JamesCarron/DiscreteOpAmp/DiscreteOpAmp_Schematics.html

# DiscreteOpAmp schematics

Every .SchDoc in C:\GitHub\DiscreteOpAmp, rendered with altium-monkey. Ctrl+scroll or browser zoom to read fine detail.

Show the whole sheet (border and title block) instead of cropping to the drawing

## Op-amp board — DiscreteOpAmp.PrjPcb

### Top level main.SchDoc

Hierarchy root: one sheet symbol per discrete design, plus a TLV271 IC op amp for comparison. Designators not yet annotated.

### Basic discrete op amp BasicDiscreteOpAmp.SchDoc

Four-transistor design: long-tailed pair, PNP gain stage, emitter-follower output.

### Advanced discrete op amp AdvancedDiscreteOpAmp.SchDoc

Current-mirror load, current-sink biasing, class-AB push-pull output.

### LM741 reference LM741_Design.SchDoc

The LM741 internal schematic as an embedded image, not drawn circuitry. In the project but not in the hierarchy or on the PCB.

## Function generator — FuncGen/FuncGen.PrjPcb

### Connectors FuncGen/Connectors.SchDoc

Top level of the function-generator project.

### Oscillator FuncGen/Oscillator.SchDoc

LMC555 square wave (trimmer-set frequency), then LMC6484 stages producing the triangle and sine outputs.

## Not in any project

### Connectors (root copy) Connectors.SchDoc

Stray copy in the repo root; differs from the FuncGen version.

### Oscillator (root copy) Oscillator.SchDoc

Stray copy in the repo root; differs from the FuncGen version.
