JamesCarron/DiscreteOpAmp/Documentation/LM741_DiscreteDesign.png

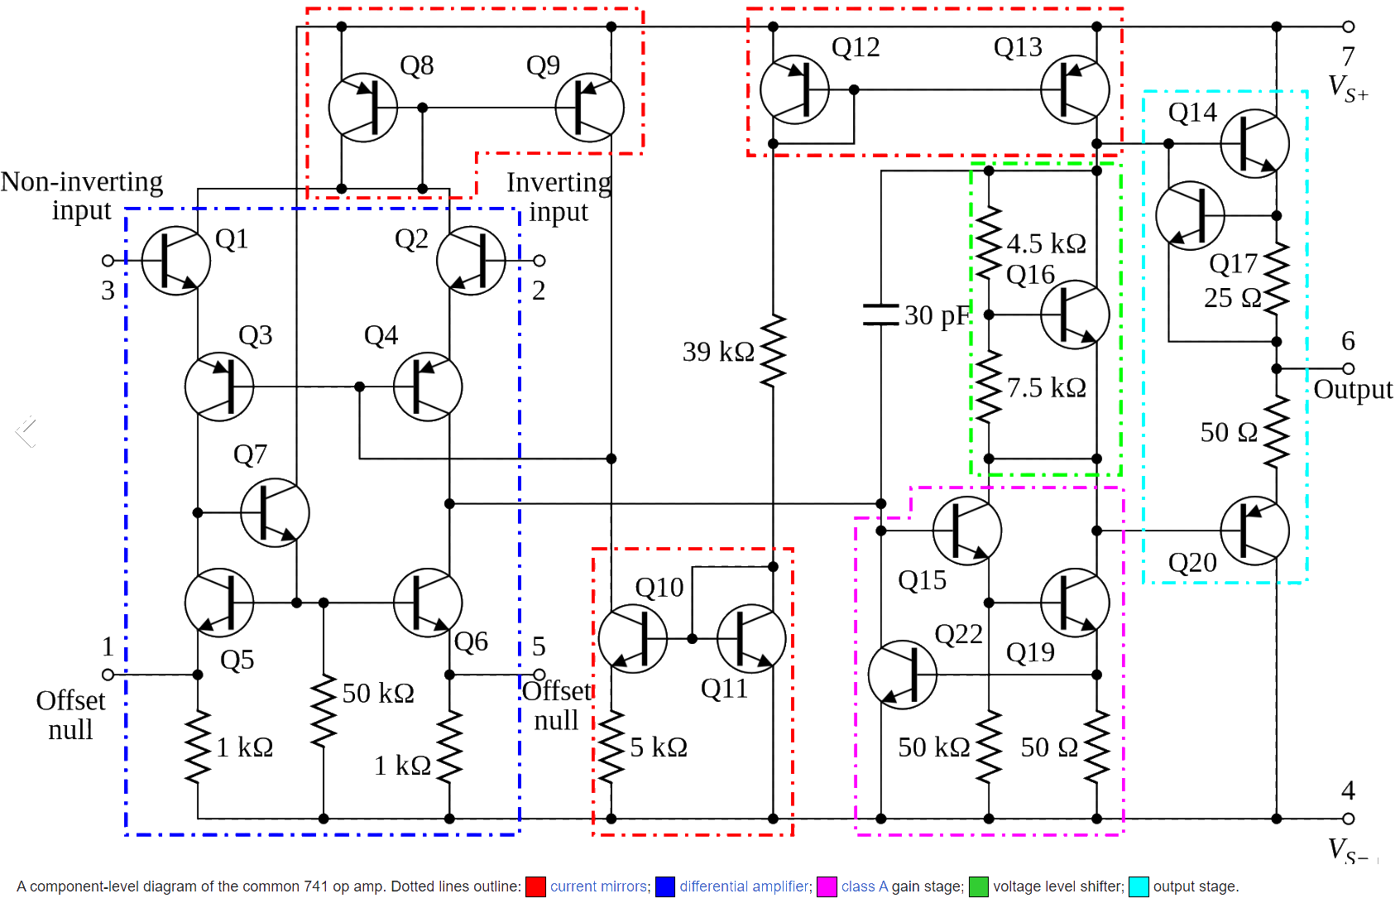
Documentation/LM741_DiscreteDesign.png
