JamesCarron/DiscreteOpAmp/(list of files, drawings)

Other design files:
AdvancedDiscreteOpAmp.SchDoc
BasicDiscreteOpAmp.SchDoc
Connectors.SchDoc
DiscreteOpAmp.PrjPcb
FuncGen/Connectors.SchDoc
FuncGen/FuncGen.PcbDoc
FuncGen/FuncGen.PrjPcb
FuncGen/Oscillator.SchDoc
LM741_Design.SchDoc
main.SchDoc
ModernOpAmp.SchDoc
Oscillator.SchDoc
PCB1.PcbDoc
PCB_Project/PCB_Project.PrjPcb
