JamesCarron/DiscreteOpAmp/(commit log)

2023-10-24 Generated Gerbers, added Docs
2026-10-19 Rewrite README: describe both projects, reference material and build status
2026-10-19 README: correct circuit descriptions against the schematics; note unannotated top sheet and stray wire
2026-10-19 Add rendered schematics page (all sheets as one self-contained HTML)
2026-10-19 README: walk through each circuit with schematic renders and reference images; add review notes on the FuncGen op-amp stages
2026-10-19 README: show the LM741 schematic from the JPG
